Hamad55556/ESP32_Smart_AC_Controller/README.md

# ESP32 Smart AC Controller
<div align="center">
  





</div>

My room AC is a basic "dumb" unit with no WiFi or smart features, which meant I had to use the remote every single time I wanted to turn it on, off, or change the temperature. Even though my phone has an IR blaster, its range was terrible, so I still had to physically get up and point it at the AC.

Since I already had an unused ESP32, some IR components, and a few spare boards lying around, I decided to turn the AC into a smart device instead of replacing it entirely.

The ESP32 clones the exact IR signals from the original remote and connects to the internet through Blynk, letting me control the AC directly from my phone. Now I can change the temperature, turn it on or off remotely, or even start cooling my room before I get home so the room is already cold when I arrive.

What started as a small convenience project ended up becoming a pretty interesting exercise in reverse engineering IR protocols, signal cleanup, and embedded systems debugging.

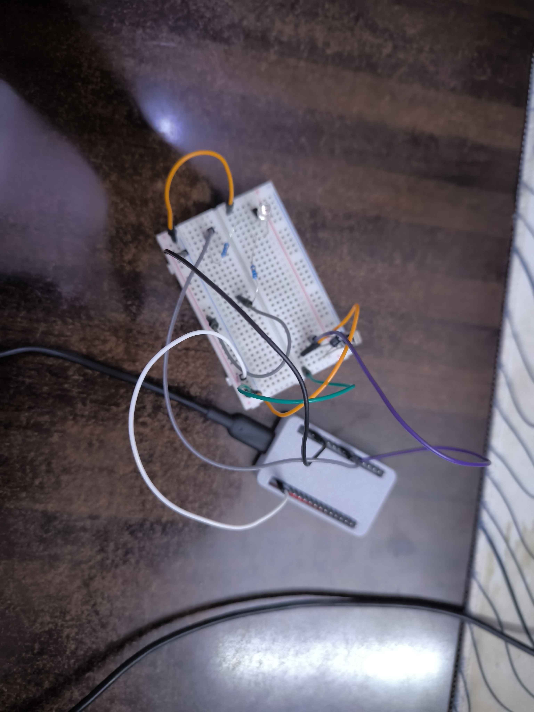
[picture p1: Setup.jpg]
setup and bad picture it works lol


---

## How it works

The ESP32 connects to WiFi and listens for commands from the Blynk app. When I tap a button on my phone, it sends the exact same IR signal the original remote would send. The AC has no idea it's not the real remote.

```
Blynk App → Blynk Cloud → ESP32 → IR LED → AC unit
```

Three buttons currently in the app:
- **OFF** — turns the AC off
- **20°C** — turns it on at 20°C
- **24°C** — turns it on at 24°C

---

## IR signal reverse engineering

The first thing I tried was finding a library or a signal database that already had my AC unit in it. I spent a while looking, but nothing worked. So, I decided to just copy the raw signal directly from the remote and replay it exactly as-is. I wired an IR receiver to the ESP32, pointed the remote at it, and started capturing.

The immediate problem was electrical noise. Every capture looked slightly different, and when I replayed the signal, the AC just ignored it. The payload is 104 bits long and encodes the full AC state temperature, mode, fan speed, everything in a single burst. If even a few bits are distorted by noise, the unit rejects the whole command.

I definitely didn't want to sit there manually cross-referencing massive arrays of numbers, so I took a different approach. What if I just captured the exact same button press a dozen times and compared them? I recorded multiple samples and had an AI filter through them to pull out the common values. Whatever stayed consistent across all the captures was the real signal, and the fluctuating numbers were just noise. I stitched those stable numbers together into a clean "Frankenstein" signal, and it worked on the first try. I repeated the process to map out OFF, 24°C, and 20°C.

Custom IR Driver: 

ESP32 GPIO pins can only push around 12mA, which isn't nearly enough to blast a signal across a room. To fix this, I used a 2N2222 NPN transistor to drive the IR LED at a 38kHz carrier frequency. The transistor acts as a low-side switch to bump the current up to the ~100mA the LED actually needs.

   Blynk Integration: 
   
   For the remote control side, I created virtual pins in the Blynk app, linked them to the ESP32, and set up the interface buttons to trigger the specific arrays over WiFi.
   
  ---

## Hardware

- ESP32 WROOM-32
- VS1838B IR receiver (GPIO 18) —> for capturing
- IR LED 940nm + 2N2222 transistor + resistors —> for sending
- Powered over USB through my pc for now but planning on putting batteries when i have free time 

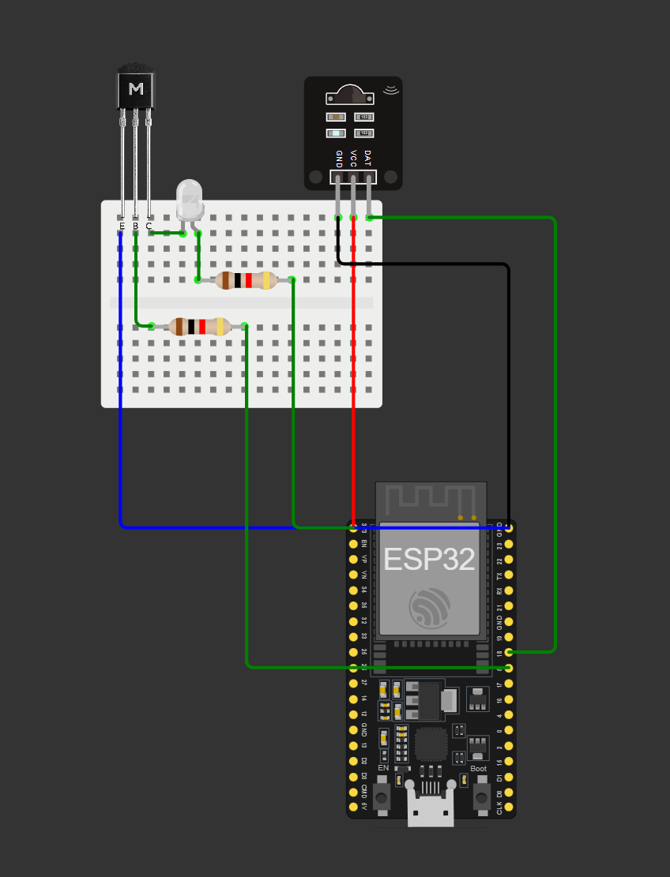
[picture p2: circuit_diagram.png]
circuit diagram


---

## Code

Two sketches:

**`ac_controller.ino`**  the main code which Connects to Blynk and waits for button presses when i press lets say 20c it fires the IR signal for that.

**`capture.ino`**  used this to capture the raw signals from the remote. Useful if you want to do the same for your own AC.

### Libraries

- `IRremote` by Armin Joachimsmeyer (tested on 4.5.0)
- `Blynk`
- `WiFi` (comes with ESP32 core)

### Setup

Fill in your credentials in `ac_controller.ino`:

```cpp
#define BLYNK_TEMPLATE_ID   "your_template_id"
#define BLYNK_TEMPLATE_NAME "your_template_name"
#define BLYNK_AUTH_TOKEN    "your_auth_token"

char ssid[] = "your_wifi";
char pass[] = "your_password";
```

In Blynk, create three button widgets set to **Push** mode:
- V0 → OFF
- V1 → 20°C
- V2 → 24°C

---

## Things I ran into

- GPIO pins on the ESP32 can't drive an IR LED directly, the signal is too weak to reach the AC unit needed a transistor to amplify it
- Default IRremote buffer is too small for AC signals and silently cuts the capture short, had to set `RAW_BUFFER_LENGTH 400`

---

## What's next if I have time

- Design a PCB and print an enclosure so it doesn't live on a breadboard or perfboard forever
- Add more temperature presets
- Blynk scheduled automations

 **Important Disclaimer**
The ESP32 must have an active internet connection for this to work. The system relies on the Blynk IoT platform to bridge the connection between your phone and the microcontroller. It does not connect to your phone directly via Bluetooth or a local offline network. If the WiFi drops, remote control is temporarily disabled.
