Hamad55556/ESP32_Smart_AC_Controller/AC_CONTROLLER.ino

#define BLYNK_TEMPLATE_ID   "your_template_id"
#define BLYNK_TEMPLATE_NAME "your_template_name"
#define BLYNK_AUTH_TOKEN    "your_auth_token"
#define BLYNK_PRINT Serial

#include <WiFi.h>
#include <WiFiClient.h>
#include <BlynkSimpleEsp32.h>
#include <IRremote.hpp>

char auth[] = BLYNK_AUTH_TOKEN;
char ssid[] = "your_wifi_name";
char pass[] = "your_wifi_password";

#define IR_SEND_PIN 5
const uint8_t kFrequency = 38;

// ==========================================
//              RAW IR SIGNALS
// ==========================================

// 20°C ON signal (reverse engineered + noise averaged)
uint16_t rawOn20[] = {
  9000, 4500,
  550, 1700, 550, 1700, 600, 550, 550, 550,
  600, 550, 550, 550, 600, 1700, 550, 1700,
  550, 1700, 550, 1700, 600, 1700, 550, 550,
  600, 550, 550, 1700, 550, 1700, 600, 550,
  550, 550, 600, 550, 550, 550, 600, 550,
  550, 550, 600, 550, 550, 550, 600, 550,
  550, 550, 600, 550, 550, 550, 600, 550,
  550, 550, 600, 550, 550, 550, 600, 550,
  550, 550, 600, 550, 550, 550, 600, 550,
  550, 550, 600, 1700, 550, 550, 600, 1700,
  550, 550, 600, 550, 550, 550, 600, 550,
  550, 550, 600, 550, 550, 550, 600, 550,
  550, 550, 600, 550, 550, 550, 600, 550,
  550, 550, 600, 1700, 550, 550, 600, 550,
  550, 550, 600, 550, 550, 550, 600, 550,
  550, 550, 600, 550, 550, 550, 600, 550,
  550, 550, 600, 550, 550, 550, 600, 550,
  550, 550, 600, 550, 550, 550, 600, 550,
  550, 550, 600, 550, 550, 550, 600, 550,
  550, 550, 600, 1700, 550, 550, 600, 550,
  550, 550, 600, 550, 550, 550, 600, 550,
  550, 550, 600, 550, 550, 550, 600, 550,
  550, 1700, 550, 550, 600, 1700, 550, 550,
  600, 550, 550, 550, 600, 1700, 550, 550,
  600, 1700, 550, 1700, 550, 1700, 550, 1700,
  600, 550, 550, 550, 600, 1700, 550, 550,
  600
};

// 24°C ON signal (verified working)
uint16_t rawOn24[] = {
  8900, 4550, 600, 1650, 600, 1700, 550, 550, 600, 550,
  550, 550, 600, 550, 550, 1700, 550, 1700, 600, 1650,
  600, 1650, 600, 1700, 550, 550, 600, 550, 550, 550,
  600, 550, 550, 1700, 550, 600, 550, 550, 600, 550,
  550, 550, 600, 550, 550, 1700, 550, 1700, 550, 1700,
  600, 550, 550, 550, 600, 550, 550, 550, 600, 550,
  550, 600, 550, 550, 600, 550, 550, 550, 600, 550,
  550, 550, 600, 550, 550, 600, 550, 1700, 550, 550,
  600, 1650, 600, 550, 550, 550, 600, 550, 550, 600,
  550, 550, 600, 550, 550, 550, 600, 550, 550, 550,
  600, 550, 550, 600, 550, 550, 550, 600, 550, 1700,
  550, 550, 600, 550, 550, 550, 600, 550, 550, 600,
  550, 550, 600, 550, 550, 550, 600, 550, 550, 550,
  600, 550, 550, 600, 550, 550, 550, 600, 550, 550,
  600, 550, 550, 550, 600, 550, 550, 550, 600, 550,
  550, 600, 500, 650, 500, 600, 550, 1700, 550, 550,
  600, 550, 550, 600, 550, 550, 550, 600, 500, 600,
  550, 600, 550, 550, 600, 550, 550, 550, 600, 1700,
  550, 550, 550, 1700, 600, 550, 550, 550, 600, 550,
  550, 1700, 550, 600, 550, 1700, 550, 1700, 550, 1700,
  550, 1700, 600, 550, 550, 550, 600, 1700, 550, 550,
  550
};

// OFF signal (verified working)
uint16_t rawOff[] = {
  8950, 4550,
  550, 1700, 550, 1700, 550, 600, 550, 550,
  600, 550, 550, 550, 600, 1650, 600, 1700,
  550, 1700, 550, 1700, 550, 1700, 550, 1700,
  600, 550, 550, 550, 600, 550, 550, 1700,
  550, 600, 550, 550, 600, 550, 550, 550,
  600, 550, 550, 1700, 550, 1700, 600, 1650,
  600, 550, 550, 550, 600, 550, 550, 600,
  550, 550, 600, 550, 550, 550, 600, 550,
  550, 550, 600, 550, 550, 600, 550, 550,
  600, 550, 550, 1700, 550, 550, 600, 1650,
  600, 550, 600, 550, 550, 550, 600, 550,
  550, 550, 600, 550, 550, 550, 600, 550,
  550, 600, 550, 550, 600, 550, 550, 550,
  600, 550, 550, 1700, 550, 600, 550, 550,
  600, 550, 550, 550, 600, 550, 550, 550,
  600, 550, 550, 550, 600, 550, 600, 550,
  550, 550, 600, 550, 550, 550, 600, 550,
  550, 550, 600, 550, 550, 600, 550, 550,
  600, 550, 550, 550, 600, 550, 550, 550,
  600, 550, 550, 600, 550, 550, 600, 550,
  550, 550, 600, 550, 550, 550, 600, 550,
  550, 550, 600, 550, 550, 600, 550, 550,
  600, 1650, 600, 550, 550, 1700, 550, 600,
  550, 550, 600, 550, 550, 1700, 550, 550,
  600, 1700, 550, 1700, 550, 1700, 550, 550,
  600, 1700, 550, 1700, 550, 550, 600, 550,
  550
};

// ==========================================
//           BLYNK VIRTUAL PINS
// ==========================================

// V0 — OFF button (push, min 0 max 1)
BLYNK_WRITE(V0) {
  if (param.asInt() == 1) {
    Serial.println(">>> BLYNK: OFF");
    IrSender.sendRaw(rawOff, sizeof(rawOff) / sizeof(rawOff[0]), kFrequency);
  }
}

// V1 — 20°C ON button (push, min 0 max 1)
BLYNK_WRITE(V1) {
  if (param.asInt() == 1) {
    Serial.println(">>> BLYNK: ON 20C");
    IrSender.sendRaw(rawOn20, sizeof(rawOn20) / sizeof(rawOn20[0]), kFrequency);
  }
}

// V2 — 24°C ON button (push, min 0 max 1)
BLYNK_WRITE(V2) {
  if (param.asInt() == 1) {
    Serial.println(">>> BLYNK: ON 24C");
    IrSender.sendRaw(rawOn24, sizeof(rawOn24) / sizeof(rawOn24[0]), kFrequency);
  }
}

// ==========================================
void setup() {
  Serial.begin(115200);
  IrSender.begin(IR_SEND_PIN);
  Serial.println("Connecting to Blynk...");
  Blynk.begin(auth, ssid, pass);
  Serial.println("Blynk Connected!");
}

void loop() {
  Blynk.run();
}
